theinsideshine/flexion_viga/README.md

# flexion_viga

[Proyecto final](doc/LRVSA_proyecto%20final.docx.pdf)

[Firmware](doc/Firmware-RLVSA.pdf)

[Hardware_sch](doc/_remote_lab_test_beam_v2.00.pdf) 

[Hardware_shield](doc/remote_lab_test_beam_shield_v2.00.pdf) 

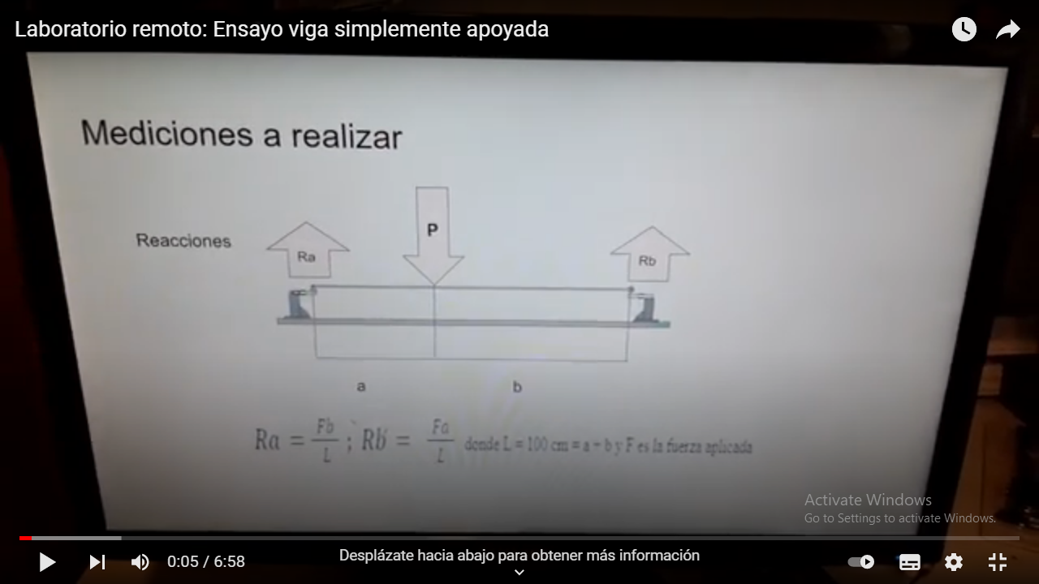
[picture p1: doc/preview_video.gif]
Ver el video (https://youtu.be/5dQEUtAvH4g)
 

[Front-end](https://github.com/theinsideshine/frontend-beam)

[Back-end](https://github.com/theinsideshine/beam_remote_lab_server)
