theinsideshine/flexion_viga/doc/LRVSA_cliente_servidor.pdf

# Cliente / Servidor

## Laboratorio remoto: Viga simplemente apoyada

UNIVERSIDAD DE LA MARINA MERCANTE, CABA, BUENOS AIRES ARGENTINA

leandro.cintioli@alumnos.udemm.edu.ar

luis.villacorta@alumnos.udemm.edu.ar

pablo.tavolaro@alumnos.udemm.edu.ar

Profesor Tutor: Marcelo Bellotti

# Cliente

Pasos a seguir para la instalación del cliente en windows

# - Instalar node JS

descargar de https://nodejs.org/en/download/ node.js, segun tu sistema operativo e instalar

probar con el cmd : node -v
npm -v

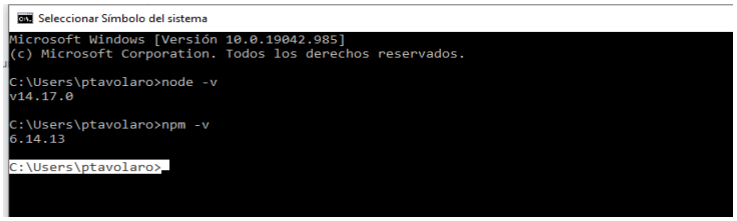
[picture p6: figure]

# - Descargar del link el código desde:

https://github.com/theinsideshine/frontend-beam/tree/master

- Descomprimirlo
- desde una consola del tipo bath situarse en la carpeta descomprimida
- ejecutar los siguiente comandos en al consola

Descargar de https://github.com/theinsideshine/frontend-beam/tree/master

ir a la ruta donde se bajo el código , descomprimirlo

# Instalación

npm install vue

npm update vue-template-compiler

npm install

npm run serve

en este momento se levantó un servidor con el cliente

npm run serve

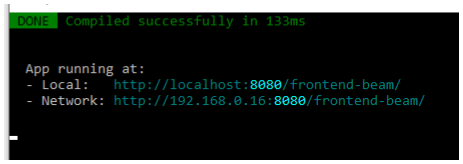
[picture p7: figure]

ir a la dirección local

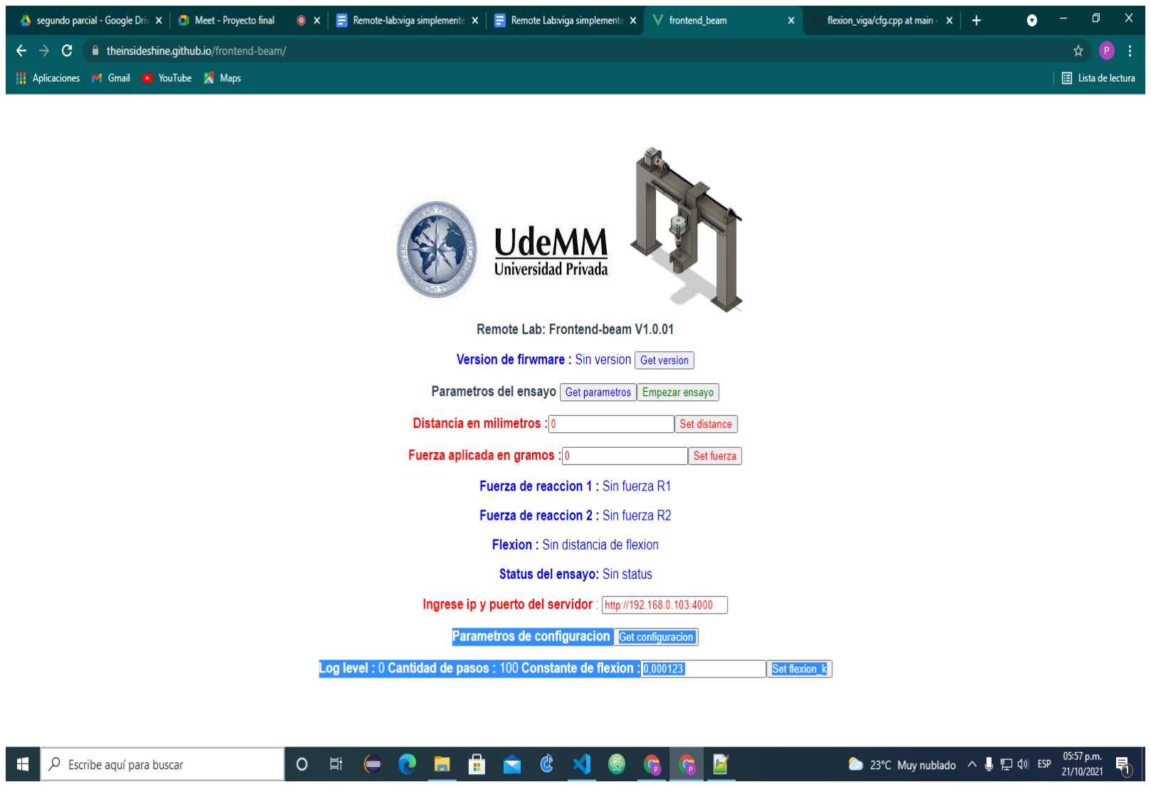
[picture p8: figure]

# Servidor

# Conexionado

Para corre el servidor tener un monitor conectado al raspberry Pi del banco por via hdmi y prender la raspberry , espera que levante el Debian (OS)

foto del monitor via hdmi

# Levantar el servidor

Al abrir el Thony ide, este está apuntando al proyecto.

bean_remote_lab_server .

ejecutarlo con la tecla RUN.

captura de pantalla del thony abierto con el boton run remarcado

# Verificar conexión

Para asegurarse la conexión entre arduino y el servidor se debe ver por la consola,

captura de pantalla de la consola del thony donde dice version de servidor y Conectado

# Dirección IP del servidor

Se necesita saber la ip vía wifi que tomó las raspberry, para configurarla en el cliente.

Captura de pantalla , visualizando la ip del raspberry
