theinsideshine/flexion_viga/doc/LRVSA_manual_del_usuario.docx.pdf

## Manual del usuario

## Laboratorio remoto: Viga simplemente apoyada

UNIVERSIDAD DE LA MARINA MERCANTE, CABA, BUENOS AIRES ARGENTINA

leandro.cintioli@alumnos.udemm.edu.ar

luis.villacorta@alumnos.udemm.edu.ar

pablo.tavolaro@alumnos.udemm.edu.ar

Profesor Tutor: Marcelo Bellotti

C.A.B.A., Buenos Aires, República Argentina 2021

## Resumen

En el presente documento se expondrán las características de operación del banco automatizado: Viga simplemente apoyada

## Objetivo

Documentar el uso del del banco del banco automatizado: Viga simplemente apoyada

## Antecedentes ( Ver anexo A)

Documento LRVSA_proyecto final_viga_simplemente_apoyada.

Documento “Proyecto Final 2019 - Banco de prueba - Viga sometida a carga puntual R3”

## Introducción

Se debe levantar el servidor que se encuentra en la raspberry pi e instalar el cliente vue en un computadora.

Para su instalación ver, Guía de instalación del cliente-servidor en el anexo A

## Desarrollo

Configurar la Ip del servidor

Una vez obtenida la ip del servidor( ver Guía de instalación del cliente-servidor en el anexo A, Dirección IP del servidor) , configurarla en el cliente

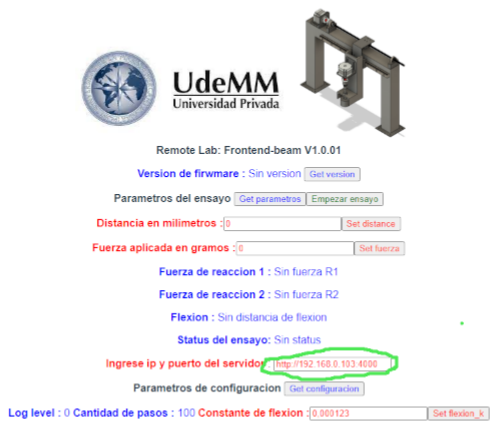
[picture p13: figure]

Verificación de conexión

Se debe apretar el botón get versión y se mostrará la versión de firmware.

captura del getVersion

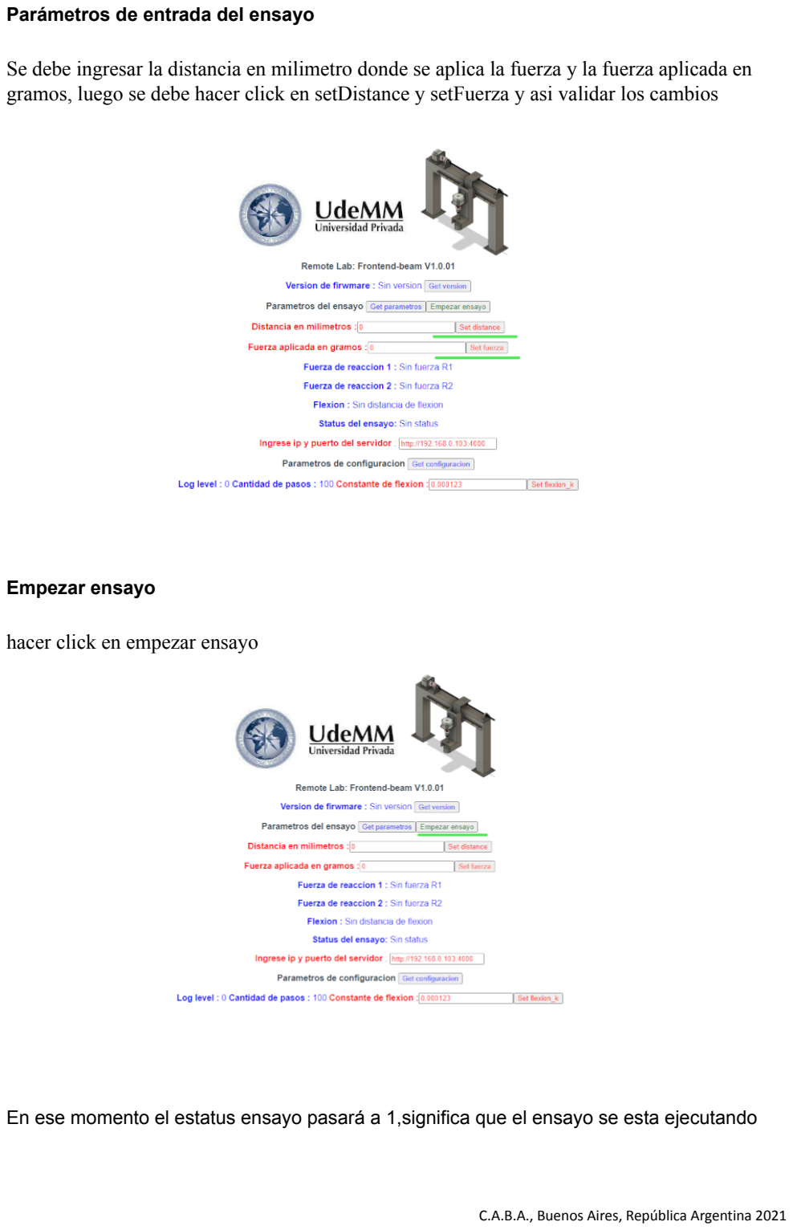
[picture p14: page 4]

Parámetros de entrada del ensayo

Se debe ingresar la distancia en milimetro donde se aplica la fuerza y la fuerza aplicada en gramos, luego se debe hacer click en setDistance y setFuerza y asi validar los cambios

Empezar ensayo

hacer click en empezar ensayo

En ese momento el estatus ensayo pasará a 1,significa que el ensayo se esta ejecutando

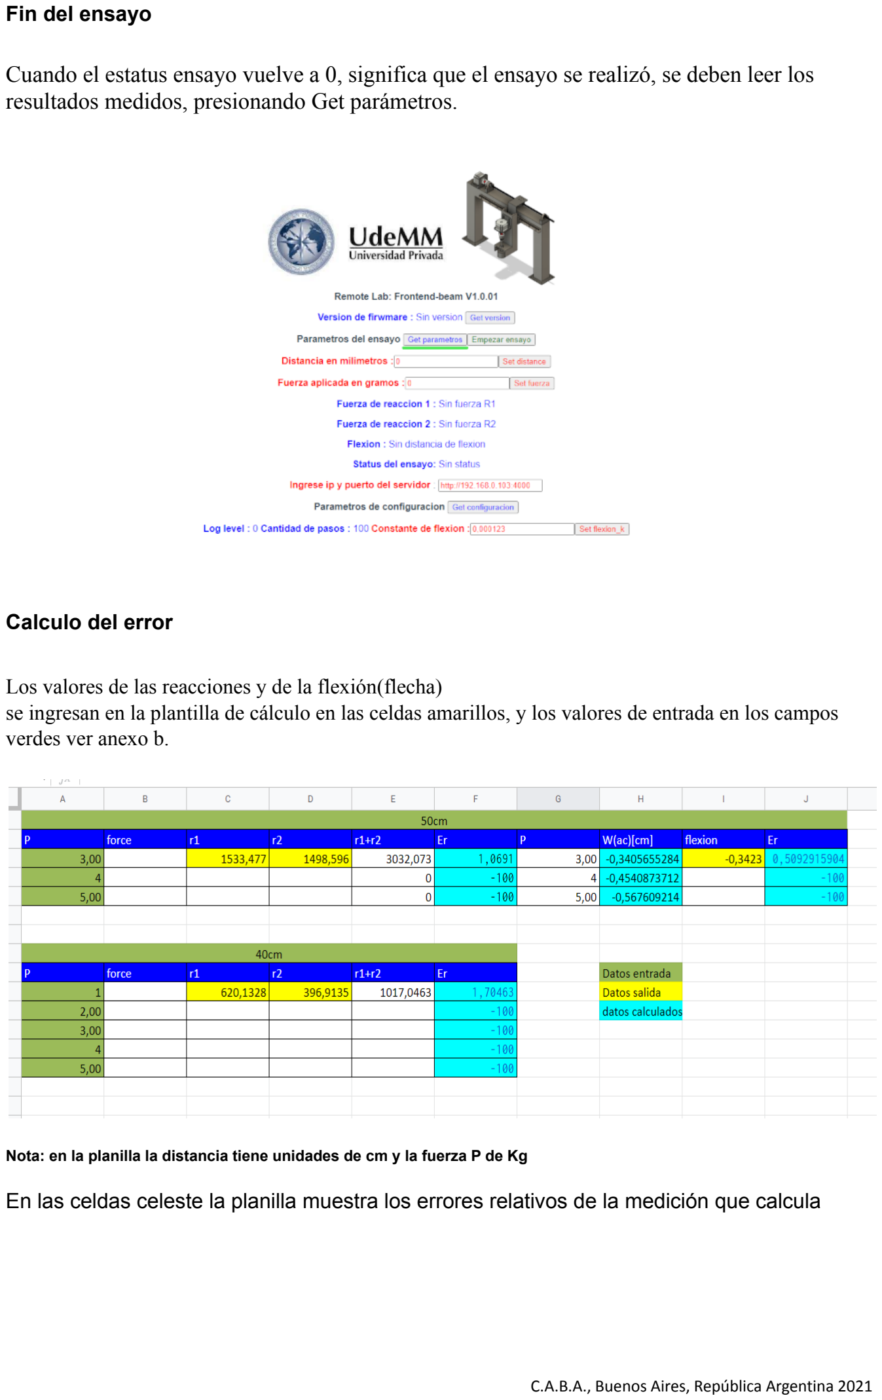
[picture p15: page 5]

Fin del ensayo

Cuando el estatus ensayo vuelve a 0, significa que el ensayo se realizó, se deben leer los resultados medidos, presionando Get parámetros.

Calculo del error

Los valores de las reacciones y de la flexión(flecha)
se ingresan en la plantilla de cálculo en las celdas amarillos, y los valores de entrada en los campos verdes ver anexo b.

Nota: en la planilla la distancia tiene unidades de cm y la fuerza P de Kg

En las celdas celeste la planilla muestra los errores relativos de la medición que calcula

Anexo A-referencias
“Proyecto Final 2019 - Banco de prueba - Viga sometida a carga puntual R3”:

Proyecto Final 2019 - Banco de prueba - Viga sometida a carga puntual R3.docx (https://docs.google.com/document/d/1DKn6gyjOr54JImm_UpJfMW8ZwHWpI_Fn/edit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)

Guia de instalación del cliente-servidor
LRVSA_cliente_servidor (https://docs.google.com/document/d/1K-YwB0meHD4Yukw2xIw6hun-QOwNnTBjYdRBvi5ZSlY/edit?usp=sharing)

Proyecto final 2021: laboratorio remoto viga simplemente apoyada LRVSA_proyecto final.docx (https://docs.google.com/document/d/1eBEjGAh_4fii9RrR9JyAIQiqG8bgasSa/edit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)

Anexo B- Planilla de cálculos

- Sección 1 : Cálculo de errores
Se usa para calcular los errores de las mediciones

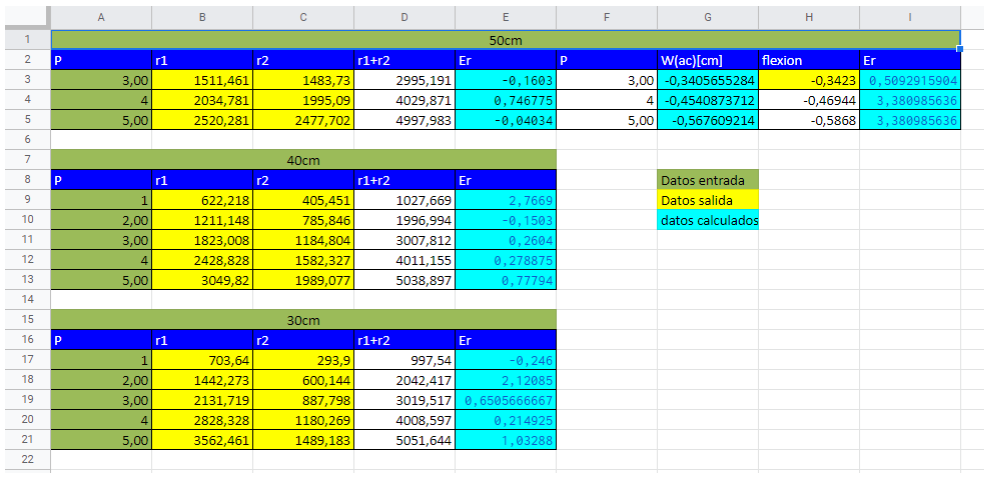
[picture p16: figure]

- Sección 2 : Referencia de flecha
en base a la ecuación de la física que rige el experimento se calculan las flechas máxima (W(ac)) a diferentes distancia a= 50 cm, a=40 cm y a= 30 cm. con distintas fuerzas aplicadas P ( de 1 a 5 Kg)

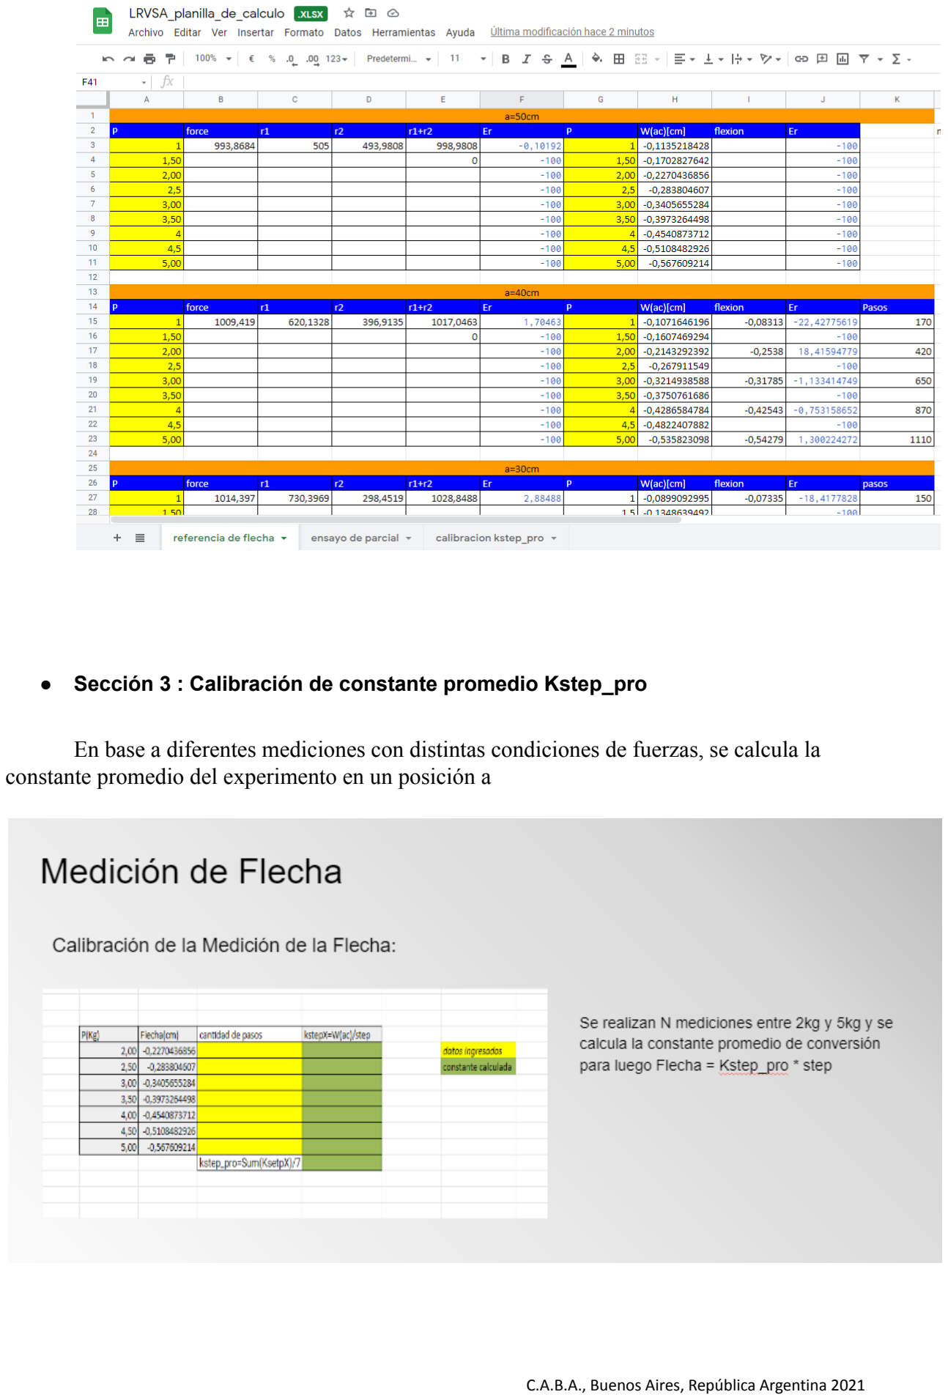
[picture p17: page 7]

- Sección 3 : Calibración de constante promedio Kstep_pro

En base a diferentes mediciones con distintas condiciones de fuerzas, se calcula la constante promedio del experimento en un posición a

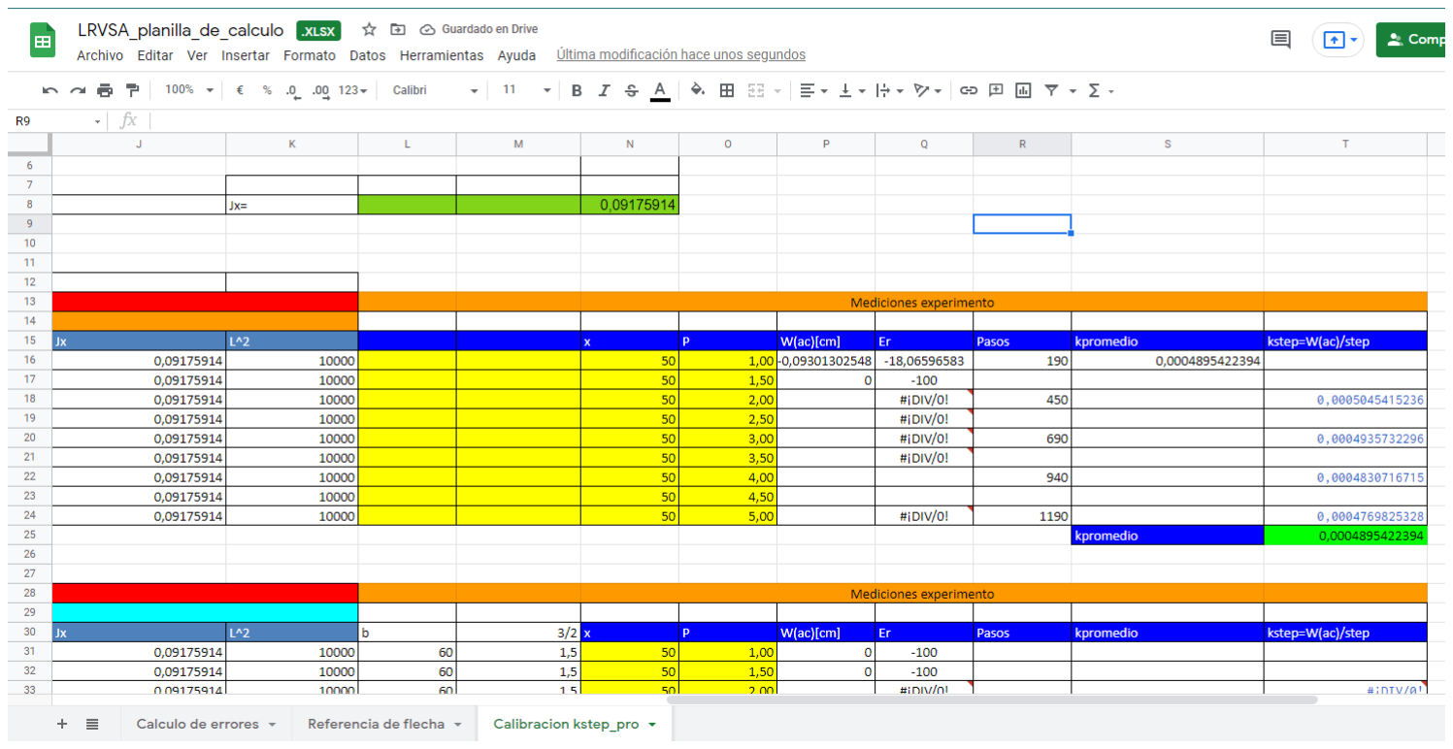
[picture p18: figure]

La planilla se encuentra en LRVSA_planilla_de_calculo.xlsx (https://docs.google.com/spreadsheets/d/1wqop4xgkYHcAhLRL03SUSc9q8NzMCKXd/edit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)
