theinsideshine/flexion_viga/doc/_remote_lab_test_beam_v2.00.pdf

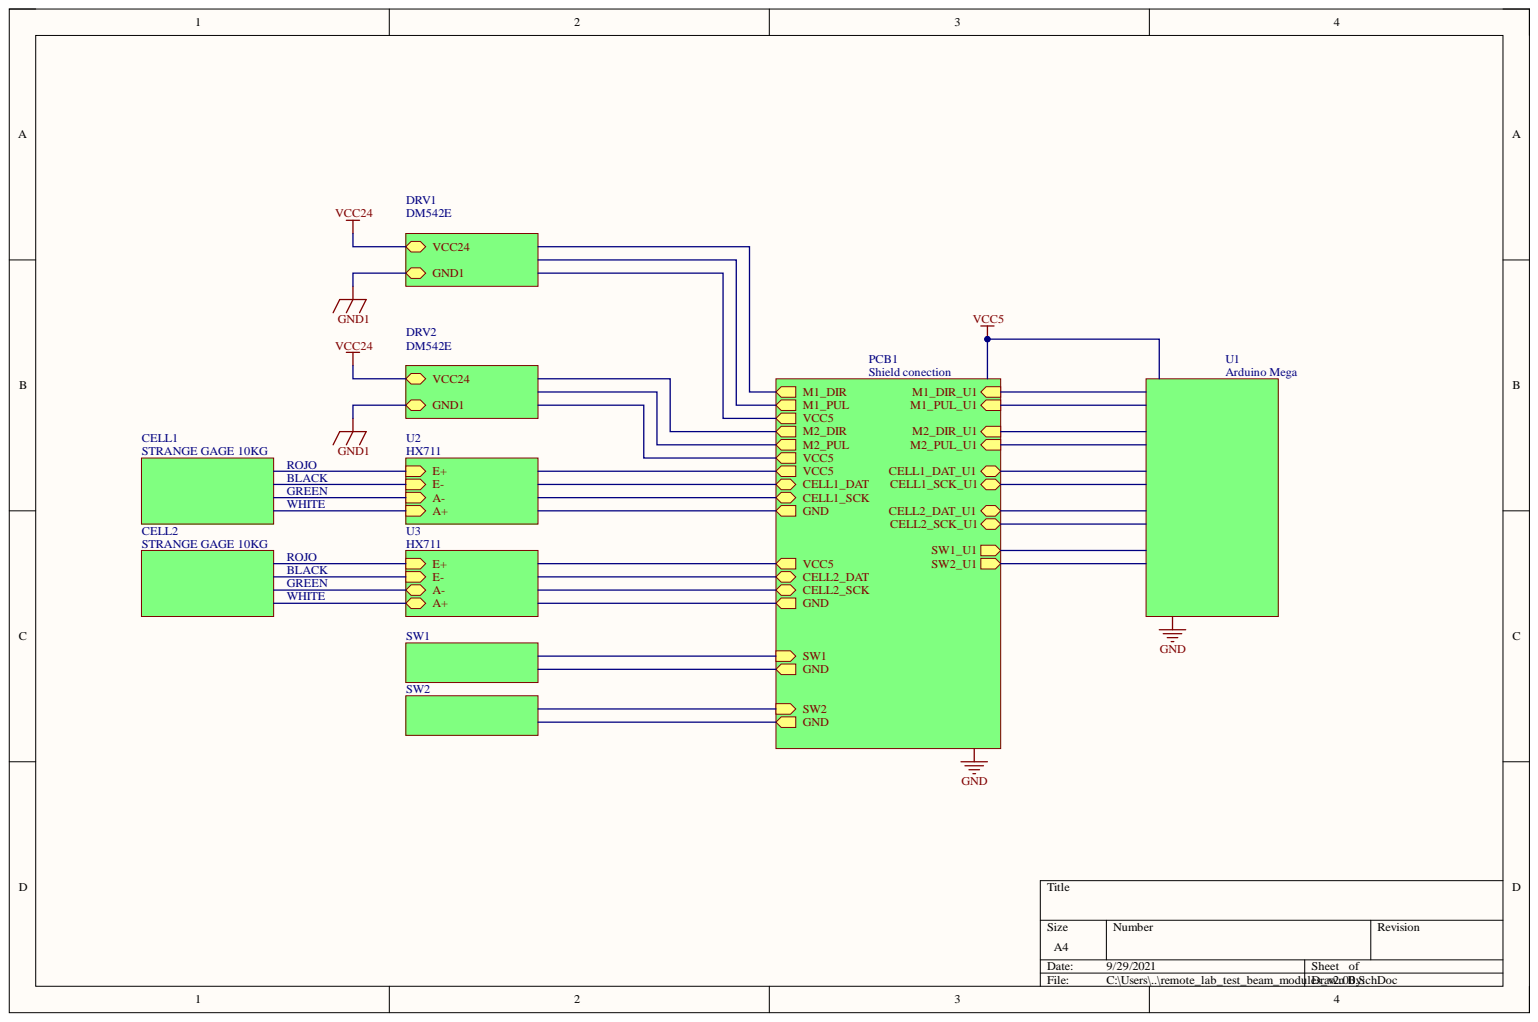
[picture p19: page 1]

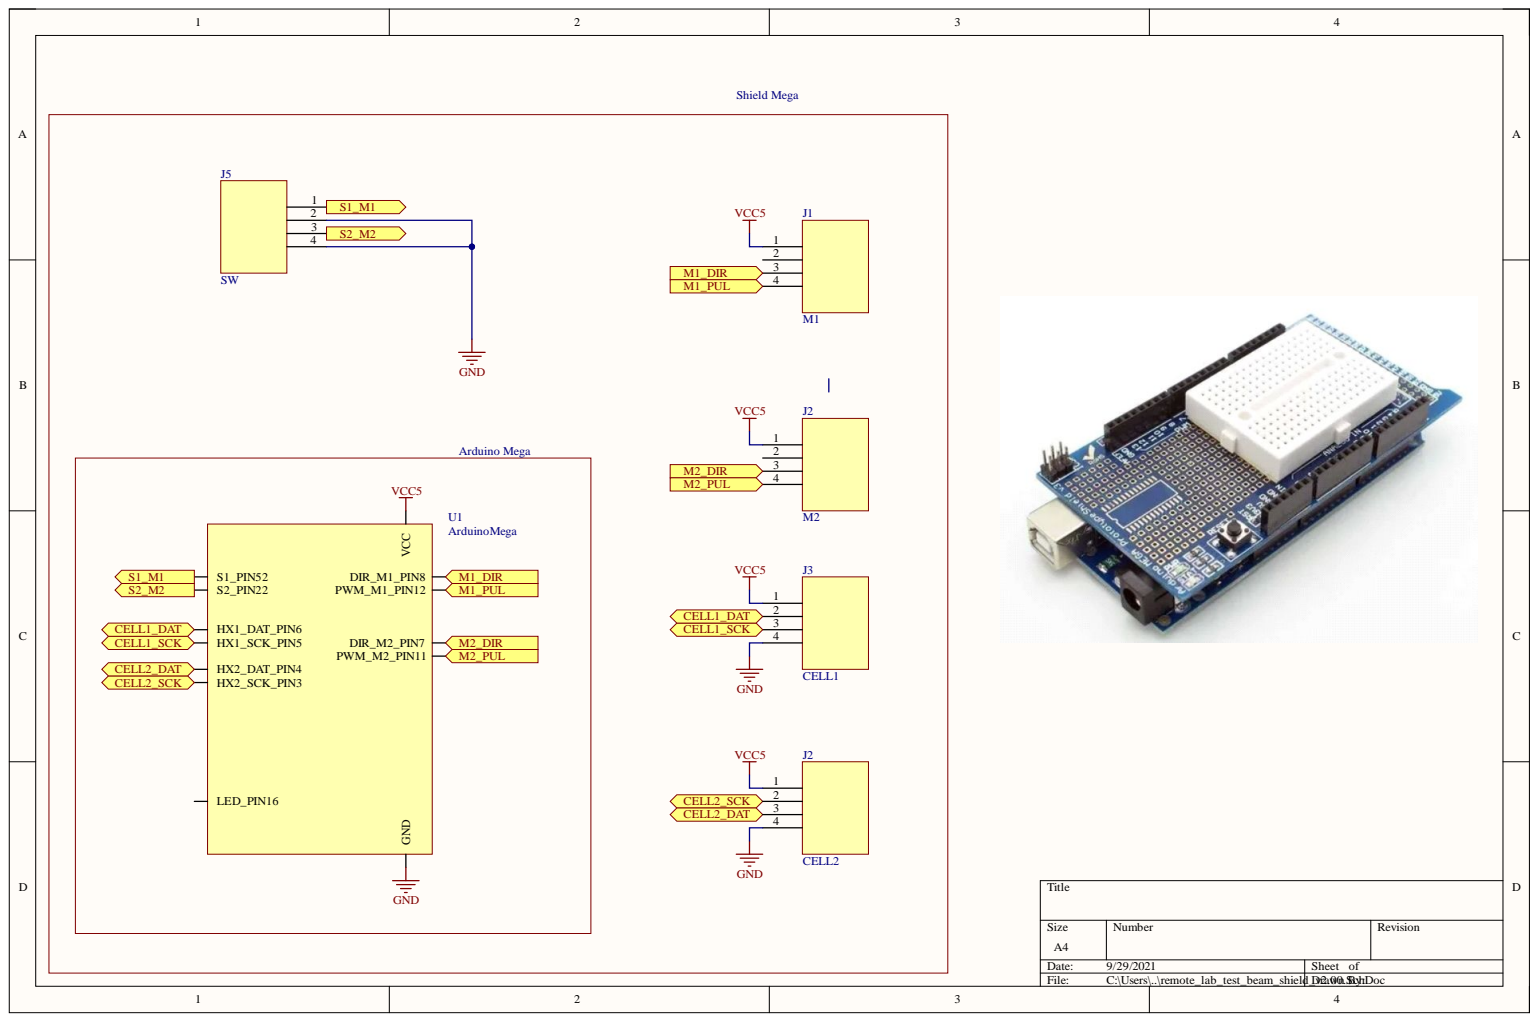
[picture p20: page 2]

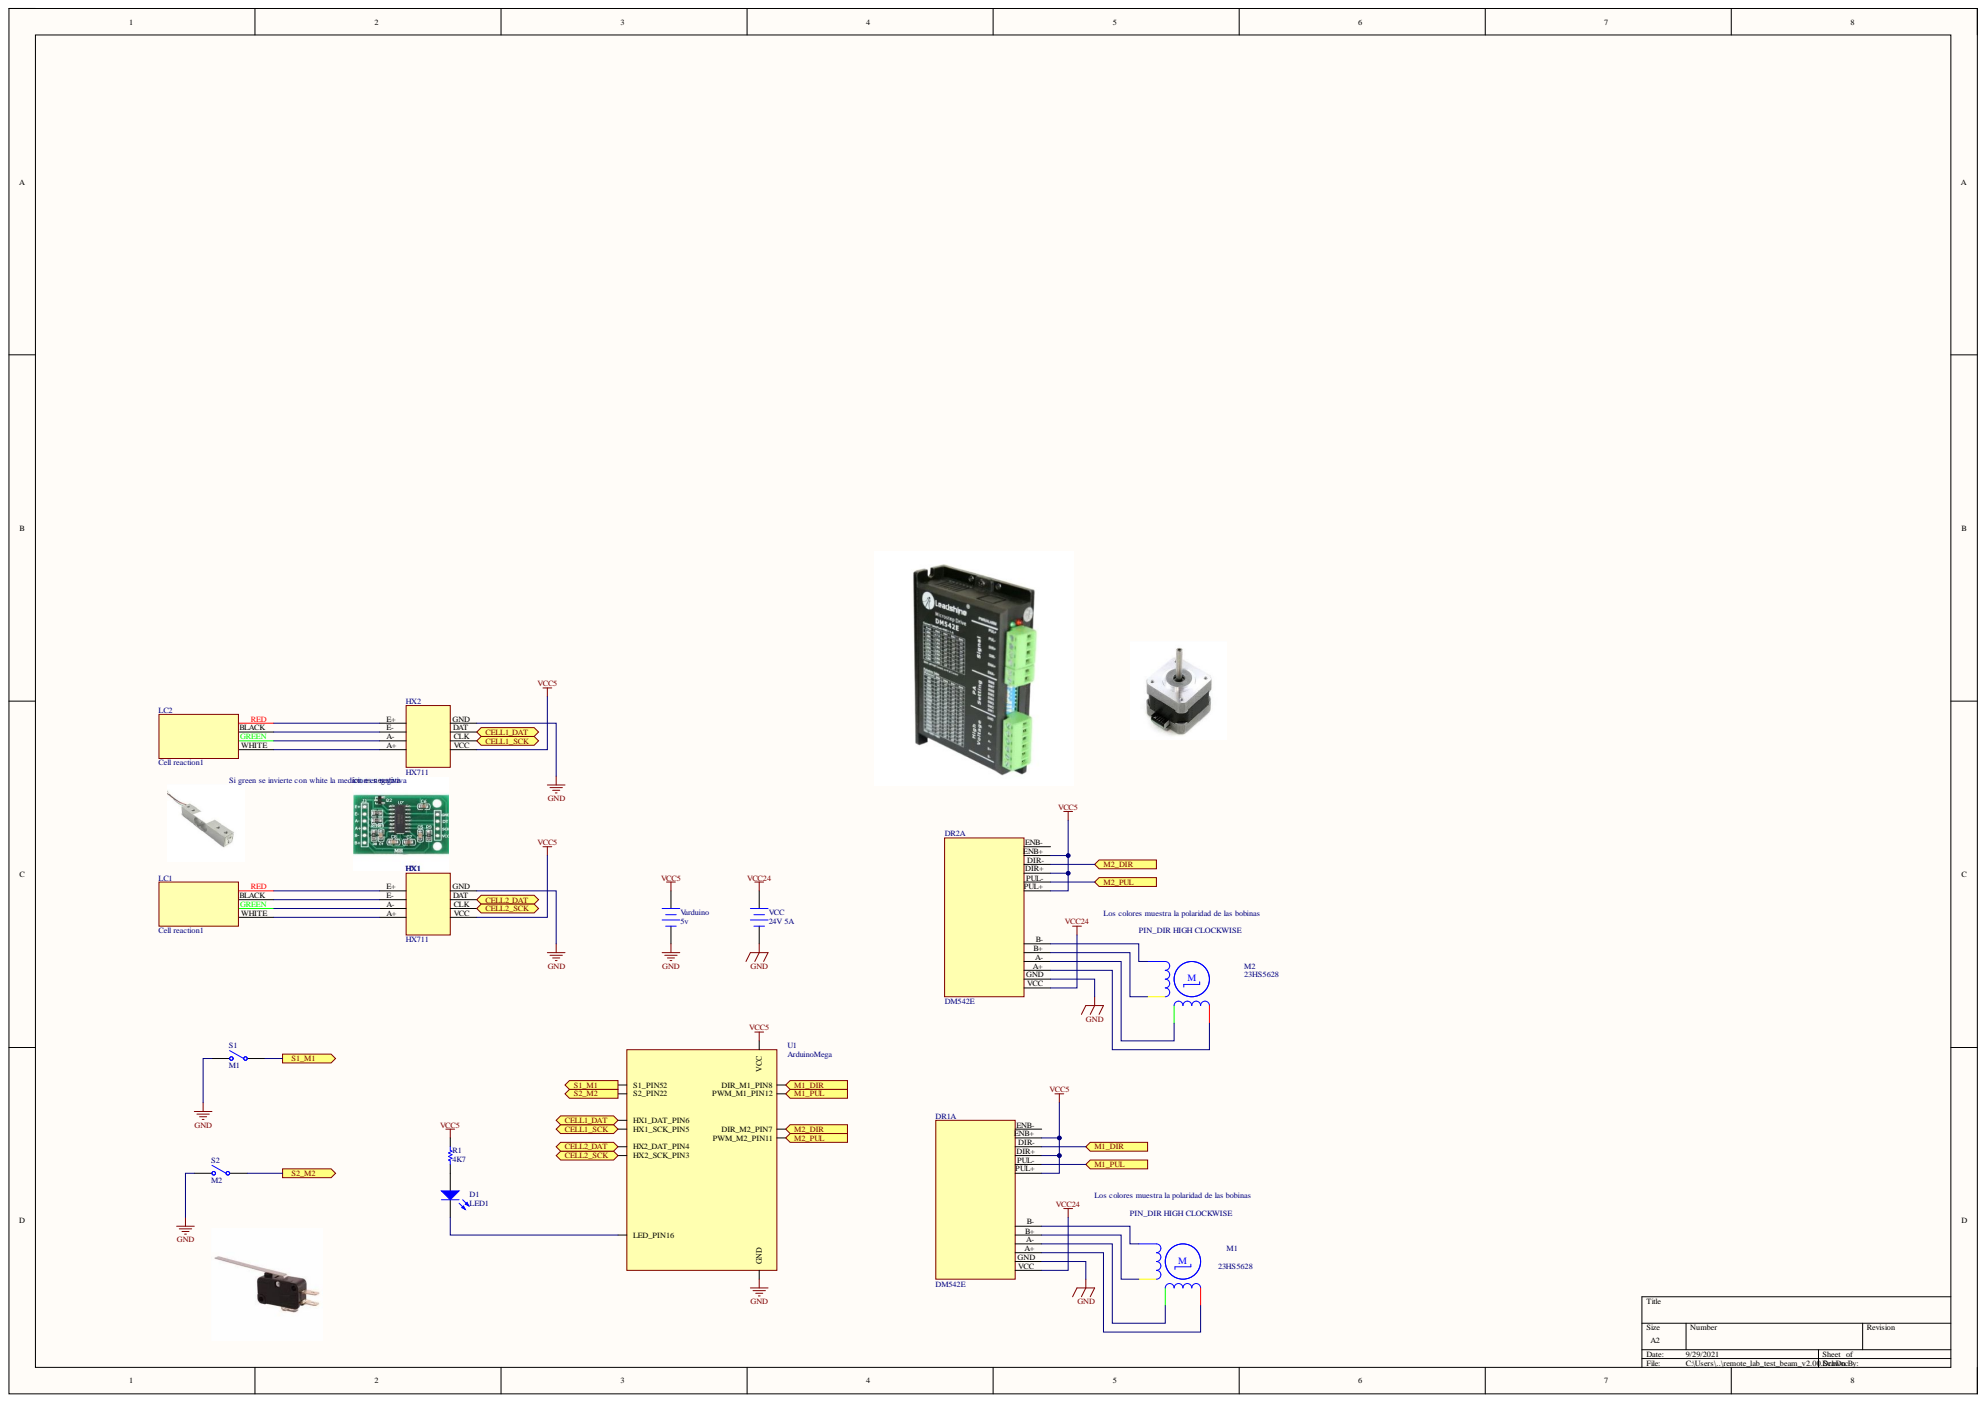
[picture p21: page 3]

BLACK E- | DAT | CELL1_DAT CELL1_SCK
GREEN A- | CLK
WHITE A+ | VCC

Si green se invierte con white la medicion es negativa

DIR-
DIR+
PUL-
PUL+

BLACK E- | DAT | CELL2_DAT CELL2_SCK

Los colores muestra la polaridad de las bobinas

B+
A-
A+
GND
VCC
