theinsideshine/flexion_viga/doc/remote_lab_test_beam_shield_v2.00.pdf

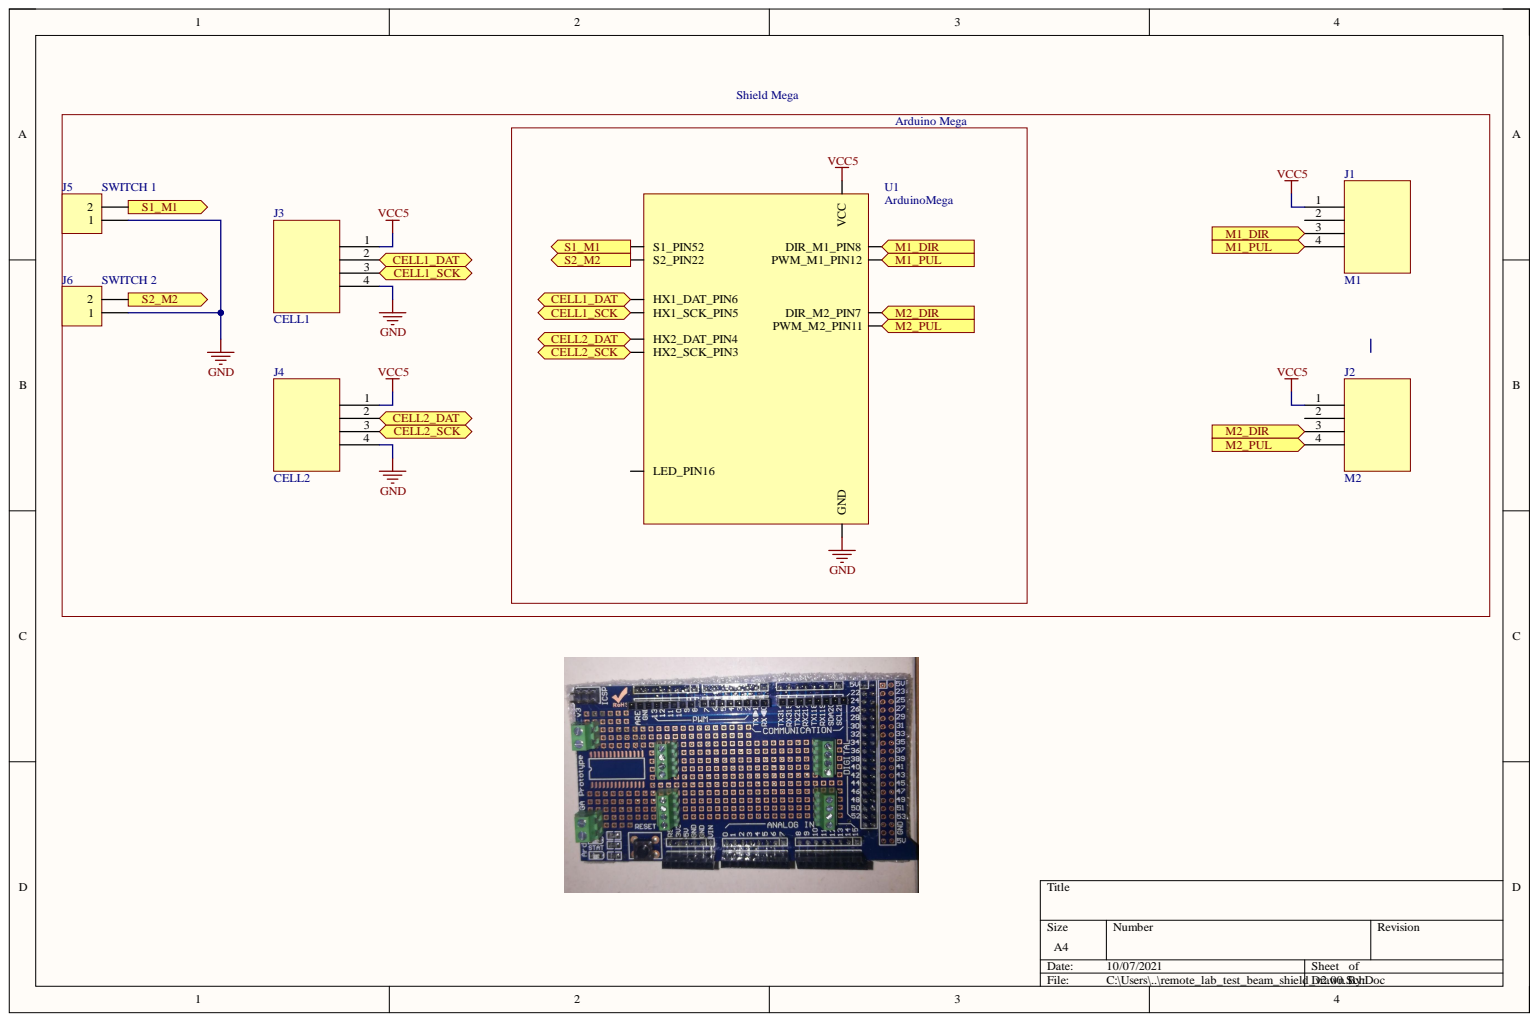
[picture p22: page 1]
