theinsideshine/flexion_viga/(commit log)

2021-04-22 Add support ST_LOOP_POINT_M1
    Added support for motor movement {'distance`: `xx`}
2021-04-24 , added {cmd: 'start'}, two buttons, two engines
    Engine functions were unified
2021-05-11 Version 0.7
    debug pin support added
    precompile macro was added
    support for prototype and real test bench was added
2021-05-11 v 1.0.08
    first approximation for manual motor support
2021-06-05 V1.0.10
    Delete manual motor add macro frecuency motor , add metode pwm
    // add macros frecuency motor
2021-06-06 v1.00.11
    New Version 1.0.11 add {m1f:'6'} Mueve 6mm el motor 1 hacia adelante
    // {m1r:'4'} Mueve 4mm el motor 1 hacia adelante
    // Se reformo tipò de dato distance en metodos del motor, se desbordaba cuando los pasos por vueltas son mayores a 200
    // Se agrego opcion de pasar la distancia requerida para mover le motor 2 x mm
2021-06-10 v1.00.12
    New Version 1.0.12 Se reparo funcion rwd_m1, desbordaba la cuenta del la cantidad de pulsos
    se puso un uint32
    Se unifico en un metodo la generacion de pulsos, los demas metodos consumen este metodo.
2021-06-19 v1.0.13
    Version 1.0.13 se agrego soporte para driver dm542E
2021-07-09 v1.0.14
    New Version 1.0.14 Pin 13 was changed to 12 (pul_mtr1), to avoid oscillations in the firmware load and reset.
    added speed macros comments for motors 1 and 2 for 200 steps per turn
    add pin strange gauge for undef TEST_PROTOTIPE
    add command host mov mtr2
    [cfg.h, flexion_viga.ino]
2021-07-11 v2.0.00
    add pin cell - add calibration cell_r1/r2.
    add direction mtr2 with macro test_prototipe
    add macro precompilation for calibration cell force
    Home blocking methods were added, to avoid mechanical breakage
    [cfg.h, flexion_viga.ino]
2021-07-31 V2.0.01
    "2.0.01" add M6 macro 1mm per revolution ,
    add STEP_PER_MM_MX for TEST_PROTOTIPE add TUNNING_CELL_FORCE
    add Motor.step_m2_down(M2_DOWN_FORCE_STEP);
    change comparation windows forc The execution of home 2 was changed before that of home 1.
2021-08-21 v2.0.03
    "2.0.03" To avoid that the motors return, being in calibration mode, it does not go back to home, in this mode
    zero reading was added to the flexion(try on the real bank)
    Beam distance conversion to useful motor distance was added
    [cfg.h, flexion_viga.ino]
2021-08-27 V2.0.04
    Se agrego parametro st_mode para ejecutar acciones
    {st_mode:'0'} st_mode ST_MODE_TEST 0 ensayo activado.
    ST_MODE_TOF 1 muestra Tof sin promedio.
    ST_MODE_TOF_AVERAGE 2 Mestra Tof con promedio.
    ST_MODE_HOME_M2 3 Home2.
    Se agrego calculo del promedio para el tof;
    Se agrego lectura del tof unicamente ( sin calculo de flexion)
    Se agrego set_cero_flexion ,usa una macro para el cero de la flexion
    Se agrego soporte para contar los pasos del motor 2 desde el home2 hasta la Fforce
    Se agrego correcion del error por contaccion en el motor 2 luego del home
    [cfg.h, flexion_viga.ino]
2021-09-04 v2.0.05
    "2.0.05" Correcion en la lectura del tof.
    Se agregaron mensajes de errores del tof.
    Se agrego parametro offset al metodo home_m2();
    Se agrego deteccion del sistema de fuerza, cargado o no.
    Se agrego macro para debug de tof ,fuerzas-paso y motor.
    [cfg.h, flexion_viga.ino]
2021-09-09 V2.0.06
    Correcion en el promedio del tof.
    Limite maximo de fuerza aplicada.
    seagrego ST_MODE_CELL para mostrar el valor de las celdas.
2021-09-10 V 2.0.07
    Se saco CALIBRATION_CELL_FORCE de la maquina principal
    Solo se usa para ver o no la fuerza cruda desde {st_mode:'4'}
2021-09-17 V2.0.08
    Se agrego fuerza minima a aplicar FORCE_MIN.
    Se cambio nombre , de flexion a tof_flexion para identificar las distintas fuentes de medicion para la flexion.
    // TODO:Cuando se modifica el cliente, quedan pendiente modificar los jSOn ejemplo {info:'flexion'} pasara a {info:'tof_flexion'
    Se agrego parametro step_flexion para devolver el calculo de la flexion medido con los pasos del motor 2.
    Se agrego calculo de flexion en milimitros con: K_CONVERTER_STEP_MM 0.000541 Se agrego macro de precompilacion CELL_FORCE_EQUAL_REACTIONS para realimentar la fuerza apli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
2021-09-17 V.2.0.085
    se dejo precompilacion para banco real
2021-09-27 2.0.09
    Cambios del 2.0.08, verificados en el banco real el 18/09/2021
    TODO: Insconsistencia entre la impresion de fuerza aplicada en st_mode=4 y pasos fuerza
2021-10-03 V3.0.00
    Se dejo lectura fuerza central solo una vez.
    Se saco tof .
    Se dejo solamente parametro del flexion calculado por cuenta de pasos
    Se saco impresion por consola de limites de fuerza, ya que el cliente no soporta mensajeria
    Se saco init de cell_force con macro de pre-compilation
2021-10-23 v3.0.01
    Comentarios - Se ordeno st_loop
    se pasason diff de V3.0.00 probada en el campo
    Se saco soporte que ya no se usa. button.cpp/h cell.cpp/h
    Se agrego soporte para calibracion desde el front-end
    STEP_CAL_DEFAULT STEP_K_DEFAULT
    {info:'all-calibration'} Envia todos los parametros en formato json de calibracion de la flexion y el nivel de logeo
